astranome/stm32basic/docs/gallery/README.md

## Gallery

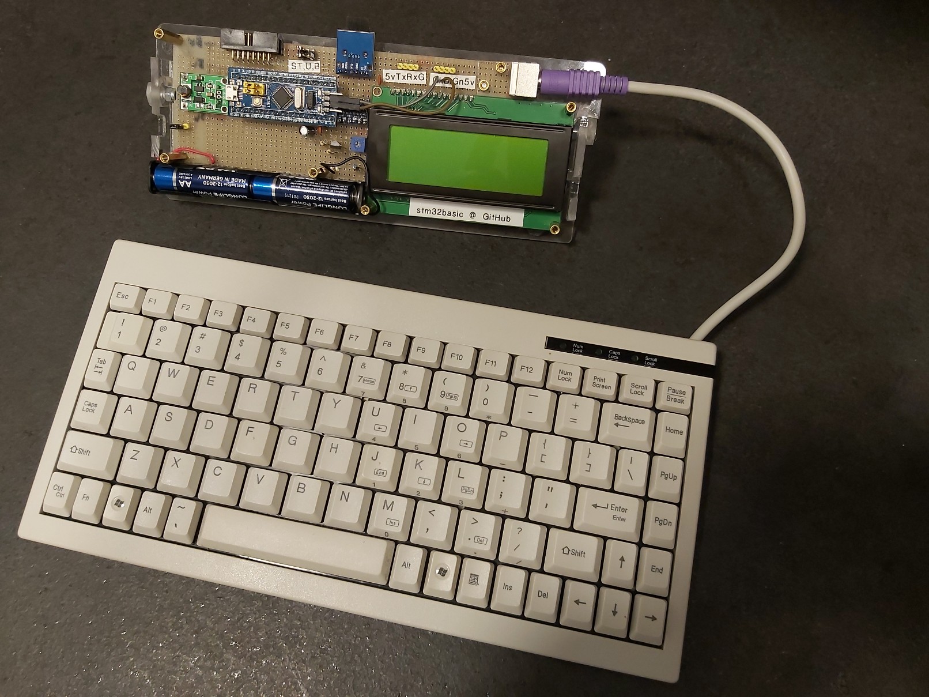
[picture p2: docs/gallery/stm32basic_1.jpg]
stm32basic_1


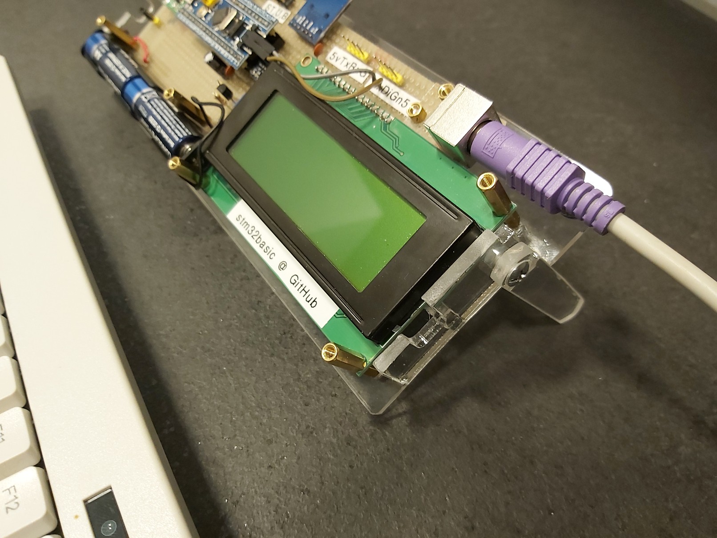
[picture p3: docs/gallery/stm32basic_2.jpg]
stm32basic_2
