astranome/stm32basic/docs/kicad/stm32basic_pc.pdf

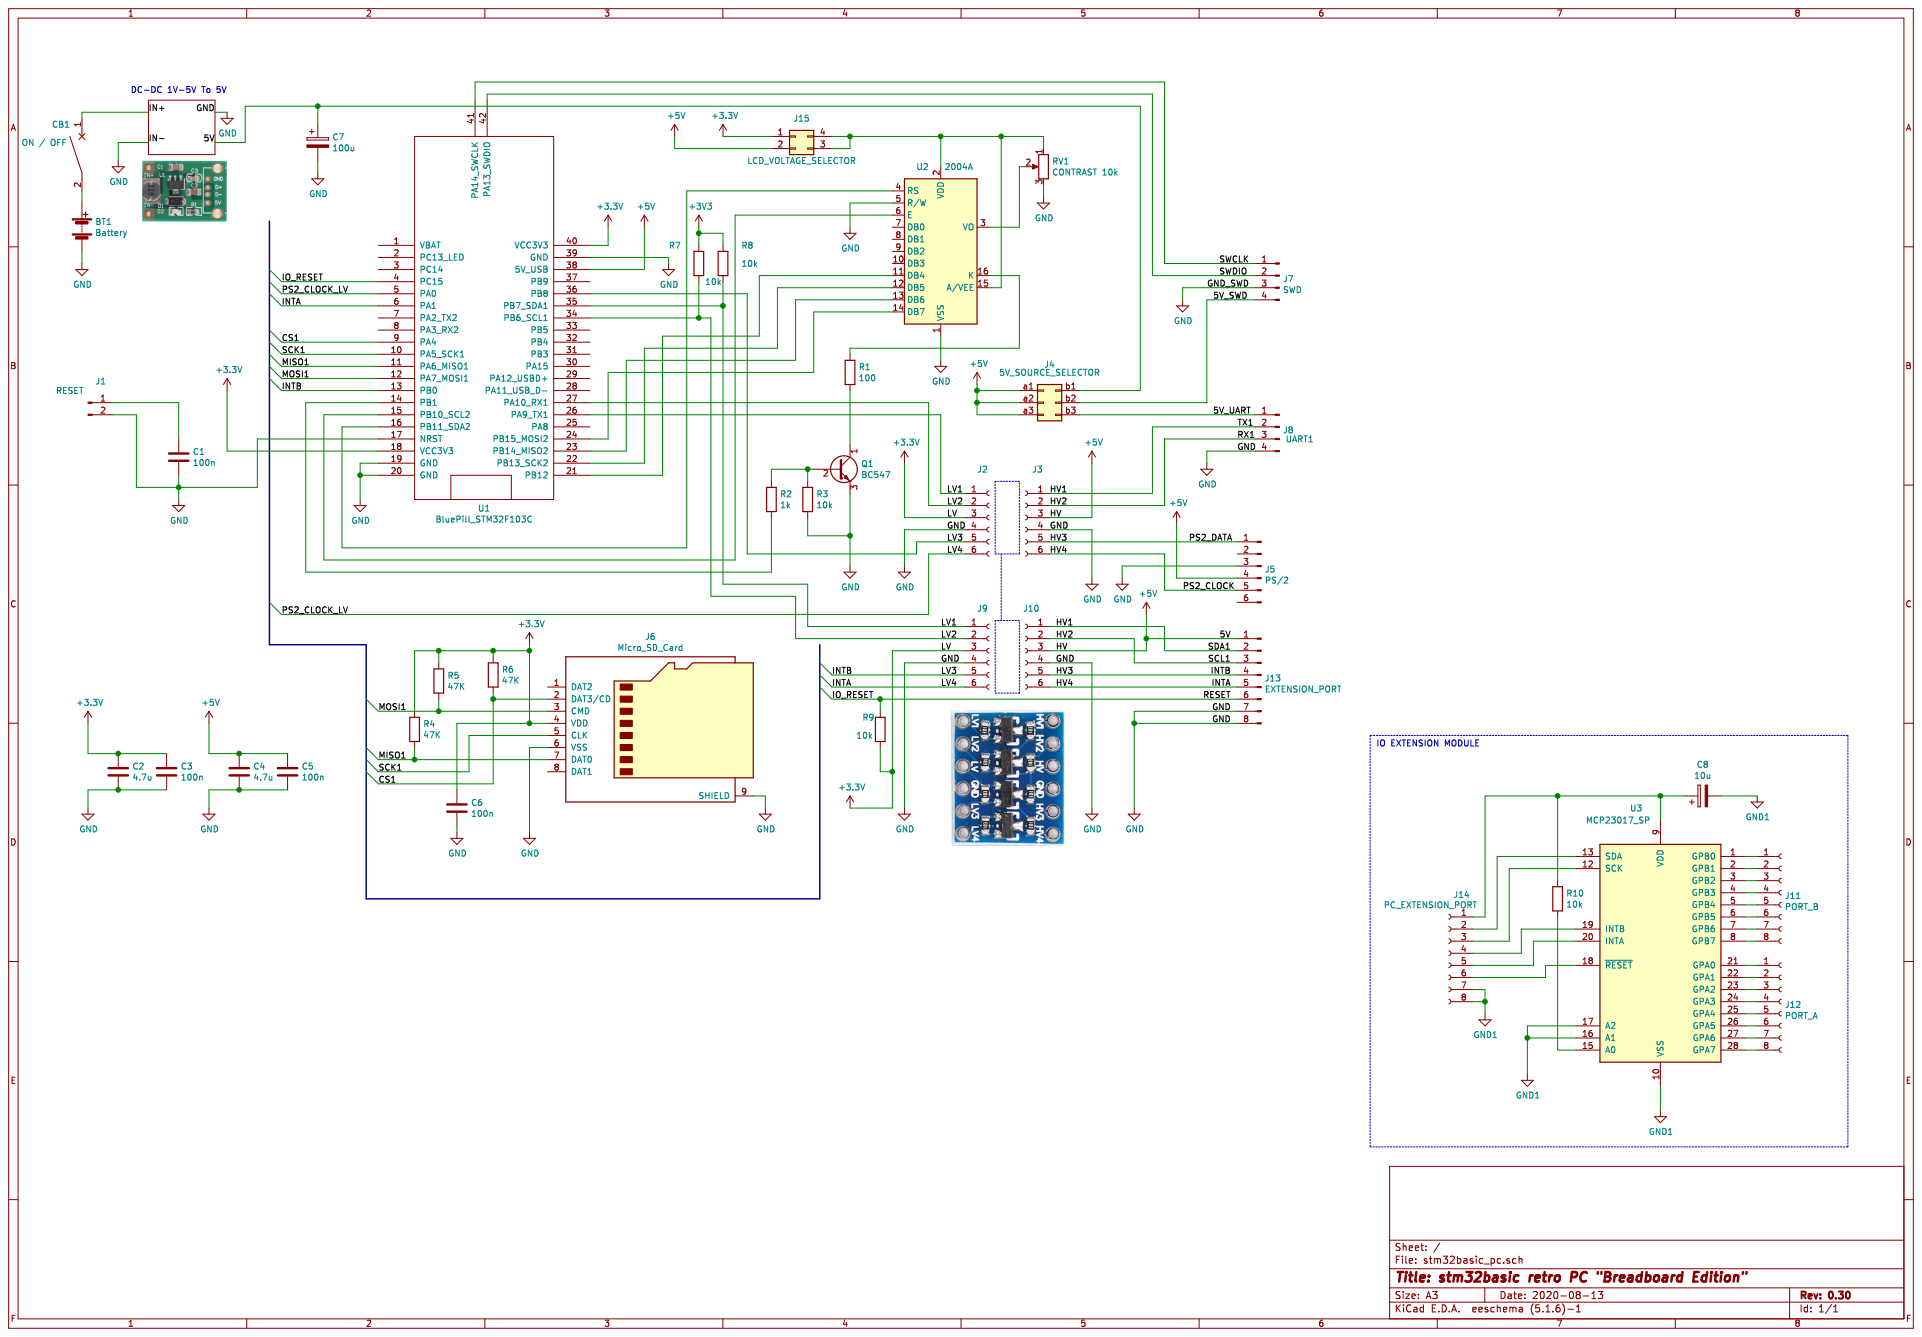
[picture p4: page 1]
