astranome/stm32basic/docs/kicad/stm32basic_pc.sch

## KiCad design docs/kicad/stm32basic_pc.sch (2020-09-02)

Schematic: stm32basic_pc.sch

Parts:
BT1: Battery
C1, C3, C5, C6: 100n
C2, C4: 4.7u
C7: 100u
C8: 10u
CB1: ON / OFF
J1: RESET
J2, J3, J9, J10: Conn_01x06_Female
J4: 5V_SOURCE_SELECTOR
J5: PS/2
J6: Micro_SD_Card
J7: SWD
J8: UART1
J11: PORT_B
J12: PORT_A
J13: EXTENSION_PORT
J14: PC_EXTENSION_PORT
J15: LCD_VOLTAGE_SELECTOR
Q1: BC547; TO-92_Inline
R1: 100
R2: 1k
R3, R7, R8, R9, R10: 10k
R4, R5, R6: 47K
RV1: CONTRAST 10k
U1: BluePill_STM32F103C
U2: 2004A; RC1602A
U3: MCP23017_SP; DIP-28_W7.62mm

Notes on the sheet:
DC-DC 1V-5V To 5V
IO EXTENSION MODULE
