astranome/stm32basic/(commit log)

2020-07-27 Schematics updated
    [stm32basic_pc.sch]
2020-07-29 Schematics updated to v0.25
    [stm32basic_pc.sch]
2020-07-30 Schematics updated to v0.26
    [stm32basic_pc.sch]
2020-08-10 Schematics updated with IO port expander
    [stm32basic_pc.sch]
2020-08-13 Schematics updated to v0.30
    [stm32basic_pc.sch]
2020-08-27 SPI SD code updated
